onurtoprak1/EE464-PeakyConverters/peaky.jpg

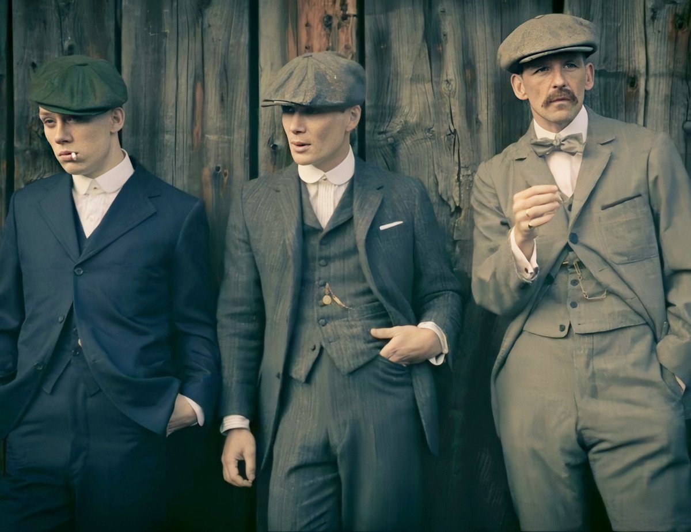
peaky.jpg
