onurtoprak1/EE464-PeakyConverters/README.md

# EE464_PeakyConverters
Onur Toprak
Çağlar Umut Özten
