onurtoprak1/EE464-PeakyConverters/simulation report/Magnetic Design calculator.xlsx

 |  |  |  |  |  | fill factor
cores | Wa | Ae | n1 | n2 | these values for Bsat =0.2T | with 3rd winding | two switch | Calculations are made with litz wire diameter of 4mm^2
55928A2 | 156 | 65.4 | 16 | 24 |  | 1.09(not possible) | 1.02
77050A7 | 38.3 | 10.9 | not possible
77310A7 | 139 | 31.7
79192A7 | 514 | 229 | 6 | 9 |  | 0.17 | 0.12
79083A7 | 427 | 107 | 10 | 15 |  | 0.33 | 0.23
79440A7 | 427 | 199 | 6 | 9 |  | 0.2 | 0.14
88071A7 | 297 | 65.4 | 16 | 24 |  | 0.76 | 0.54
88894A7 | 156 | 65.4 | 16 | 24 |  |  | 1.02
79894A7 | 156 | 65.4 | 16 | 24 |  |  | 1.02
77442A7 | 427 | 199 | 6 | 9 |  | 0.2 | 0.14
77439A7 | 427 | 199 | 6 | 9 |  | 0.2 | 0.14
77111A7 | 948 | 144 | 8 | 12 |  | 0.12 | 0.09
75192A7 | 514 | 229 | 6 | 9 |  | 0.17 | 0.12
 |  |  |  |  | these values for Bsat =0.2T | fill factor |  | if turns ratio 1:2
00K4022E090 | low AL |  | N1 | N2 |  | with 3rd winding | two switch
00K3515E090 | low AL
00K6527E060 | low AL
00K7228E060 | low AL
0P45530EC | 375 | 420 | 4 | 8 |  | 0.13 | 0.1
0P43517EC |  | 84.3
0P45959EC | 509 | 368 | 5 | 10 |  | 0.13 | 0.1
