onurtoprak1/EE464-PeakyConverters/design handouts/2039Fig01-T.gif

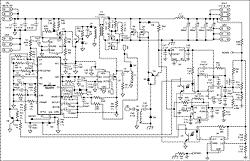
design handouts/2039Fig01-T.gif
