onurtoprak1/EE464-PeakyConverters/component lists/analog controller/analog controller.docx

1. https://www.e-komponent.com/flyback-forward-converter-regulator-dc-dc-controller-ic-ucc2897argpr
