onurtoprak1/EE464-PeakyConverters/component lists/list for sponsorship.xlsx

Ürün Tipi | Ürün Adı | Link | Adet | Grup Adı
MOSFET | IRF540N | https://ozdisan.com/power-semiconductors/mosfets/discrete-mosfets/IRF540NPBF/3488 | 4 | PeakyConverters
MOSFET | IRF640N | https://ozdisan.com/power-semiconductors/mosfets/discrete-mosfets/IRF640NPBF/336688 | 4 | PeakyConverters
MOSFET | IRFP260NPBF | https://ozdisan.com/guc-yari-iletkenleri/mosfetler/discrete-mosfetler/IRFP260NPBF/3517 | 2 | PeakyConverters
DIODE | DSA30C200IB | https://ozdisan.com/power-semiconductors/diodes-diode-modules-and-rectifiers/schottky-diodes/DSA30C200IB/483108 | 8 | PeakyConverters
DIODE | DSA30C100IB | https://ozdisan.com/guc-yari-iletkenleri/diyotlar-modul-diyotlar-ve-dogrultucular/schottky-diyotlar/DSA30C100PB/483083 | 4 | PeakyConverters
DIODE | DSA60C150PB | https://ozdisan.com/guc-yari-iletkenleri/diyotlar-modul-diyotlar-ve-dogrultucular/schottky-diyotlar/DSA60C150PB/352425 | 4 | PeakyConverters
HEATSINK | OZDAS0098EL25 | https://ozdisan.com/elektromekanik-komponentler/sogutucular/aluminyum-sogutucular/OZDAS0098EL25/495565 | 6 | PeakyConverters
HEATSINK | 145AS15 | https://ozdisan.com/elektromekanik-komponentler/sogutucular/aluminyum-sogutucular/145AS15-AL-SOGUTUCU/443451 | 6 | PeakyConverters
Pertinaks | DELİKLİ PERTİNAKS 10X10 | https://ozdisan.com/maker-ve-iot-urunleri/maker-arac-ve-gerecleri/prototipleme-devreleri/DELIKLI-PERTINAKS-10X10/643012 | 3 | PeakyConverters
Pertinaks | DELİKLİ PERTİNAKS 5X5 | https://ozdisan.com/maker-ve-iot-urunleri/maker-arac-ve-gerecleri/prototipleme-devreleri/DELIKLI-PERTINAKS-5X5/643014 | 4 | PeakyConverters
CONTROLLER | NCP1252ADR2G | https://ozdisan.com/integrated-circuits-ics/power-management-ics/ac-dc-converters-and-offline-switchers/NCP1252ADR2G/700706 | 2 | PeakyConverters
DRIVER | IR2106 | https://ozdisan.com/entegre-devreler-icler/guc-entegreleri/guc-surucu-entegreleri/IR2106PBF/445888 | 3 | PeakyConverters
Klemens | 2'li Bariyer Klemens | https://www.direnc.net/2li-bariyer-klemens | 3 | PeakyConverters
Optocoupler | LTV-816 | https://ozdisan.com/optolar-ve-sensorler/optolar/transistor-ve-fotovoltaik-cikisli-optokuplorler/LTV-816/356190 | 1 | PeakyConverters
Jak | Orta Boy Jak | https://www.direnc.net/4mm-born-jak-seffaf-kirmizi-orta-boy | 2 | PeakyConverters
Jak | Orta Boy Jak | https://www.direnc.net/4mm-born-jak-seffaf-siyah-orta-boy | 2 | PeakyConverters
IC Socket | 8-Pin IC Socket | https://ozdisan.com/konnektor-ve-baglanti-elemanlari/entegre-soketleri/entegre-soketleri/L-KLS1-216-20/457430 | 2 | PeakyConverters
Voltaj Regülatör | LM2596 | https://www.robolinkmarket.com/lm2596-ayarlanabilir-dc-dc-voltaj-regulatoru | 2 | PeakyConverters
CAPACITOR | 330uF | https://ozdisan.com/pasif-komponentler/kapasitorler/aluminyum-kapasitorler/PKLH-063V331MG200-TA5-0/501299 | 2 | PeakyConverters
CAPACITOR | 1nF | https://ozdisan.com/pasif-komponentler/kapasitorler/seramik-kapasitorler/TMCC02-102M250VP7-5A/484623 | 2 | PeakyConverters
CAPACITOR | 100nF | https://ozdisan.com/pasif-komponentler/kapasitorler/film-kapasitorler/C242A104J2SA201/348506 | 2 | PeakyConverters
CAPACITOR | 4.7uF | https://ozdisan.com/pasif-komponentler/kapasitorler/aluminyum-kapasitorler/WL2A475M05011PA/358155 | 2 | PeakyConverters
CAPACITOR | 1uF | https://ozdisan.com/pasif-komponentler/kapasitorler/aluminyum-kapasitorler/PKR2-063V010MB070-TA5-0/341120 | 2 | PeakyConverters
CAPACITOR | 300nF | https://ozdisan.com/pasif-komponentler/kapasitorler/film-kapasitorler/R76MKP3J250/5293 | 2 | PeakyConverters
CAPACITOR | 470pF | https://ozdisan.com/pasif-komponentler/kapasitorler/film-kapasitorler/FKP2D004701D00JSSD/355199 | 2 | PeakyConverters
CAPACITOR | 100pF | https://ozdisan.com/pasif-komponentler/kapasitorler/seramik-kapasitorler/TMCC02-101K1000VP5A/518294 | 2 | PeakyConverters
CAPACITOR | 22uF | https://ozdisan.com/pasif-komponentler/kapasitorler/aluminyum-kapasitorler/PKRM-050V220MC110-T2-5/347642 | 2 | PeakyConverters
INDUCTOR | 2.2uH | https://ozdisan.com/pasif-komponentler/induktorler/sabit-induktorler/SMPI06050-2R2M/532739 | 1 | PeakyConverters
INDUCTOR | 10uH 12X12 10A | https://www.direnc.net/10uh-12x12-10a-smd-guc-bobini-sri1209 | 1 | PeakyConverters
INDUCTOR | 10uH 12X12 9.2A | https://www.direnc.net/10uh-12x12-92a-smd-guc-bobini-sri1207 | 1 | PeakyConverters
Akım sensörü | ACS712-30A | https://www.direnc.net/acs712-30a-smd-akim-sensoru-entegresi-soic8 | 1 | PeakyConverters
Akım sensörü | ACS712 | https://www.direnc.net/acs712-akim-sensoru-30a-30a-modul | 1 | PeakyConverters
POT | 5k | https://ozdisan.com/elektromekanik-komponentler/potansiyometreler-ve-trimpotlar/cevrilebilir-potansiyometreler/WH148-1A-2-20V-B5K/1059609 | 2 | PeakyConverters
POT | 2k | https://ozdisan.com/elektromekanik-komponentler/potansiyometreler-ve-trimpotlar/cevrilebilir-potansiyometreler/WH148-1A-2-20V-B2K/1059608 | 2 | PeakyConverters
POT | 1k | https://ozdisan.com/elektromekanik-komponentler/potansiyometreler-ve-trimpotlar/cevrilebilir-potansiyometreler/WH148-1A-2-20V-B1K/1059607 | 2 | PeakyConverters
