onurtoprak1/EE464-PeakyConverters/component lists/components to consider.docx

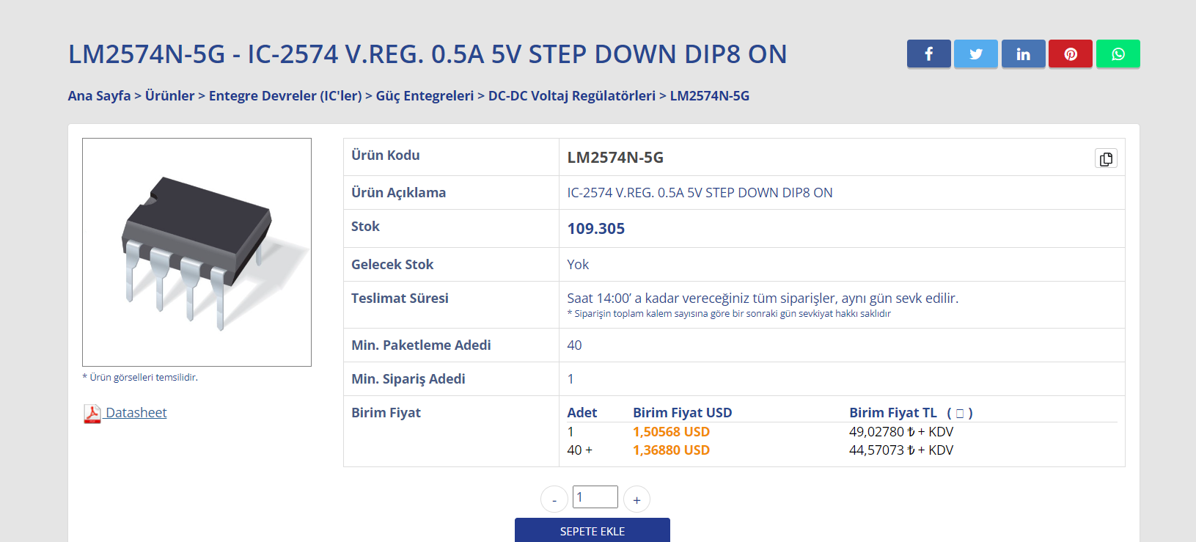
[picture p82: figure]
metin, elektronik donanım, ekran görüntüsü, yazılım içeren bir resim Açıklama otomatik olarak oluşturuldu
