onurtoprak1/EE464-PeakyConverters/component lists/driver/driver.docx

1. https://www.e-komponent.com/converter-offline-forward-secondary-side-sr-topology-16-ssop-2578
