onurtoprak1/EE464-PeakyConverters/final report/schematic_term_project.pdf

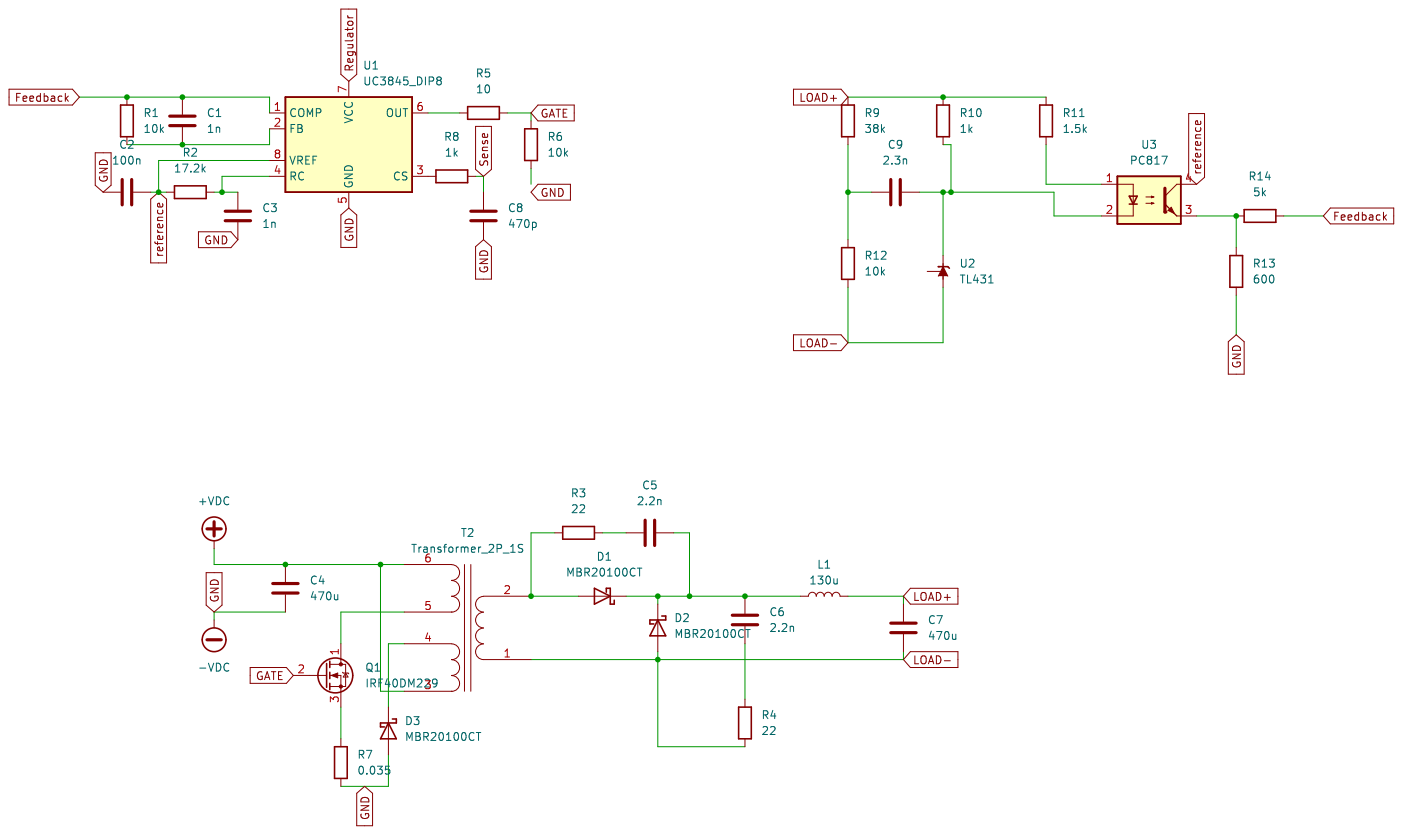
[picture p93: page 1]
