onurtoprak1/EE464-PeakyConverters/spice simulations/Analog_Controller_V_2.asc

C1: cap; 470n
C2: cap; 500µ
C3: cap; 100p
C4: cap; 100p
C5: cap; 4.7n
C6: cap; 1n
C7: cap; 1µ
D1: schottky; PDS5100
D2: schottky; MBR20100CT
D3: schottky; MBR20100CT
D5: schottky; PDS5100
L1: ind2; 9
L2: ind2; 15
L3: ind; 130µ
M1: nmos; BSB015N04NX3
M2: nmos; BSB015N04NX3
R1: res; 2.4
R2: res; 172k
R3: res; 200k
R4: res; 20k
R5: res; 0.15
R6: res; 10k
R7: res; 0.008
R8: res; 1k
R9: res; 1k
R10: res; 0.8
U1: LT1246
U2: PC817A
V1: voltage; 40
Named nets: 0
.tran 0 0.01 0 1
K L1 L2 1
