onurtoprak1/EE464-PeakyConverters/spice simulations/peaky_forward_uc8345.asc

C2: cap; 470p
C4: cap; 1n
C9: polcap; 470µ; V=35 Irms=1.06 Rser=0.0442 Lser=7.087n
C10: cap; 470µ
C11: cap; 2.3n
C13: cap; 100n
C14: cap; 1n
D1: diode; MBR20100CT
D2: schottky; MBR20100CT
D4: diode; MBR20100CT
L1: ind; 0.215µ
L2: ind; 100µ
L3: ind2; 1
L4: ind2; 2.25
L5: ind; 0.215µ
L6: ind2; 1
M2: nmos; IRFR120Z
R3: res; 17.2k
R4: res; 8.87
R5: res; 1k
R7: res; 2.4
R8: res; 38k
R9: res; 10k
R10: res; 1k
R11: res; 1.5k
R13: res; 0.6k
R14: res; 5k
R15: res; 10k
R18: res; 0.035
R19: res; 10k
U1: tl431
U2: PC817A
U3: LT1245
V1: voltage; 15
Vin: voltage; 20
Named nets: Isense, Reference, Output, 0, Feedback, Vout, Vcc
.tran 0.02
K L3 L4 L6 1
.include tl431.lib
