onurtoprak1/EE464-PeakyConverters/spice simulations/two sw.asc

C1: cap; 45µ
C2: cap; 10µF
D1: schottky; MBR20100CT
D2: schottky; MBR20100CT
D3: schottky; MBR20100CT
D4: schottky; MBR20100CT
L1: ind2; 100µ
L2: ind2; 225µ
L3: ind; 130µ
M1: nmos; BSB014N04LX3
M2: nmos; BSB014N04LX3
R1: res; 2.4
V1: voltage; 40
V2: voltage; PULSE(0 10 0 1e-7 1e-7 2e-6 1e-5)
V3: voltage; PULSE(0 10 0 1e-7 1e-7 2e-6 1e-5)
Named nets: 0
K L1 L2 1
.tran 0 0.1 0
