onurtoprak1/EE464-PeakyConverters/spice simulations/Converter.asc

C1: cap; 100µ
C2: cap; 100µ
D1: schottky; MBR20100CT
D2: diode; MBR20100CT
D3: diode; MBR20100CT
L1: ind2; 100µ
L2: ind2; 225µ
L3: ind2; 100µ
L4: ind; 50µ
L5: ind; 30µ
L6: ind; 0.1µ
L7: ind; .1µ
M1: nmos; BSB012N03LX3
R1: res; 2.4
R2: res; 0.13
R3: res; 0.194
V1: voltage; 40
V2: voltage; PULSE(0 50 0 10n 10n 2e-6 1e-5)
Named nets: 0
K1 L1 L2 L3 1
.tran 0 0.01 0 100
