onurtoprak1/EE464-PeakyConverters/(commit log)

2024-04-08 Magnetic desşgn from HW1 is uploaded
2024-04-20 excel table and handouts added
    [Magnetic Design calculator.xlsx]
2024-04-21 Magnetic design calculations are added
    [Magnetic Design calculator.xlsx]
2024-04-21 Add files via upload
    Simulation results of Charger Design
2024-04-21 Add files via upload
    Practical Schematic of the Topology
2024-04-24 Component list and designs on driver, controller added
    [Magnetic Design calculator.xlsx, list for sponsorship.xlsx]
2024-06-13 Add files via upload
    schematic design and final results are added
